Tanjim67/interactive-system/resource/Pressure sensor method 1/IMG_20200611_221741.jpg

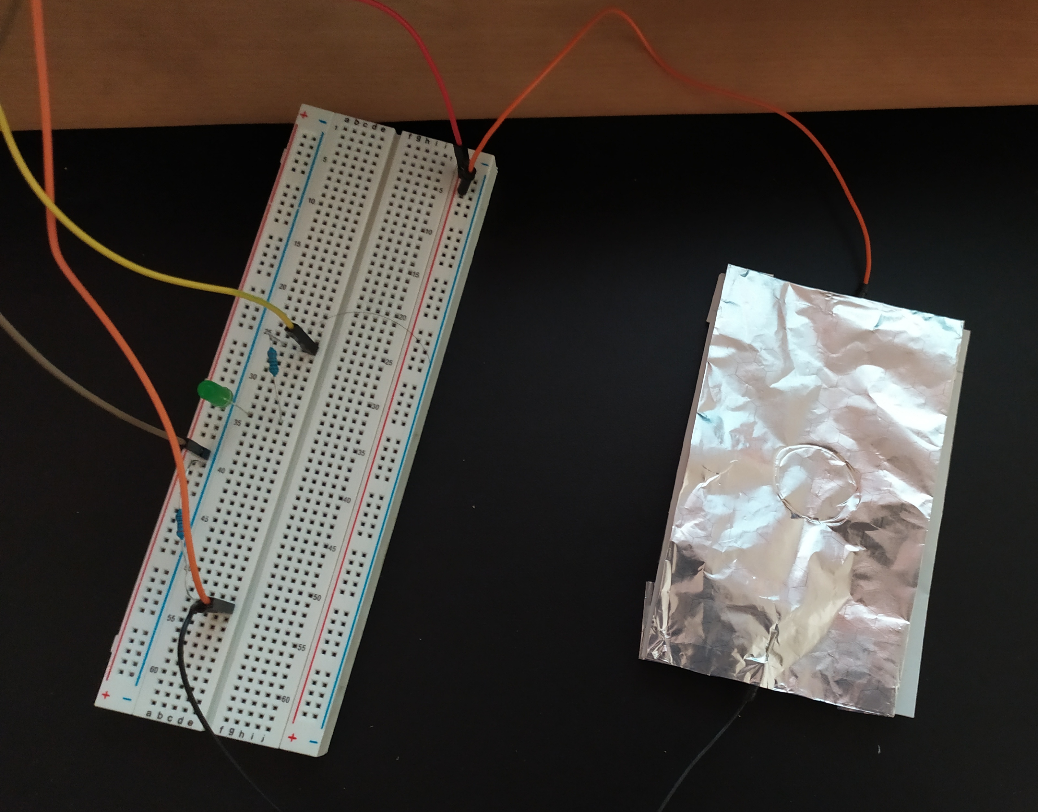
resource/Pressure sensor method 1/IMG_20200611_221741.jpg
