Tanjim67/interactive-system/resource/Pressure Sensor Method 2/IMG_20200622_030150.jpg

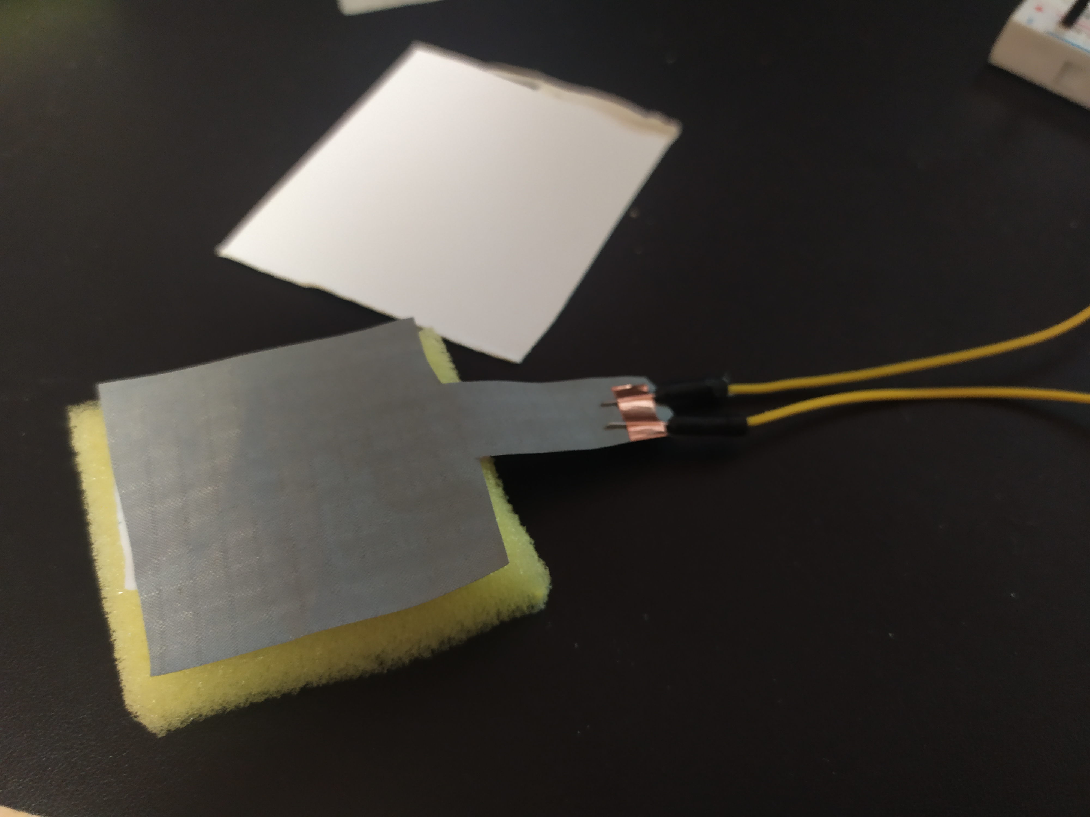
resource/Pressure Sensor Method 2/IMG_20200622_030150.jpg
