Tanjim67/interactive-system/data/1velostat.PNG

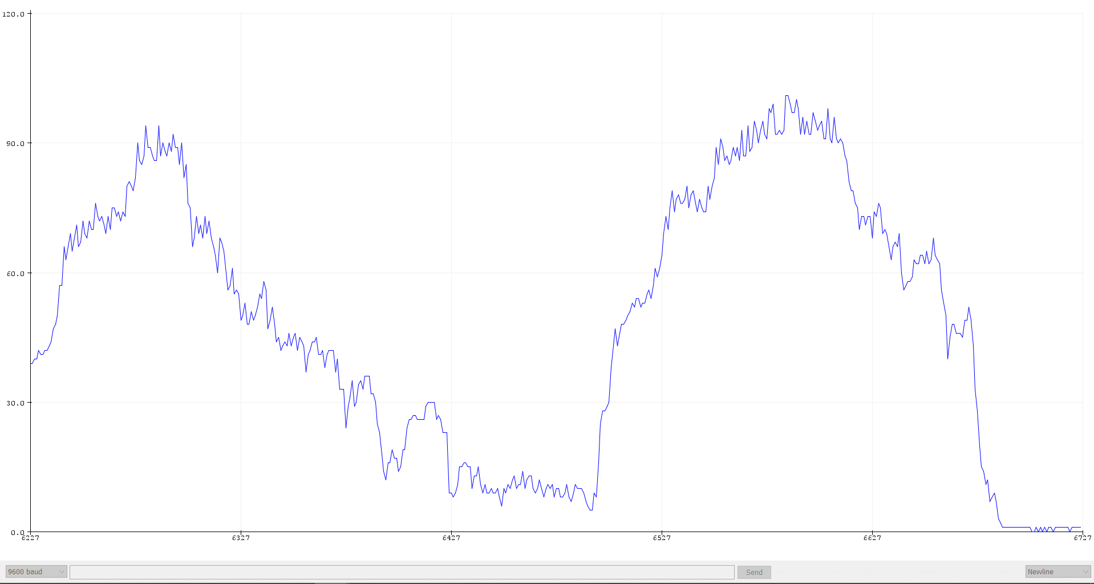
data/1velostat.PNG
