Tanjim67/interactive-system/data/3velostat.PNG

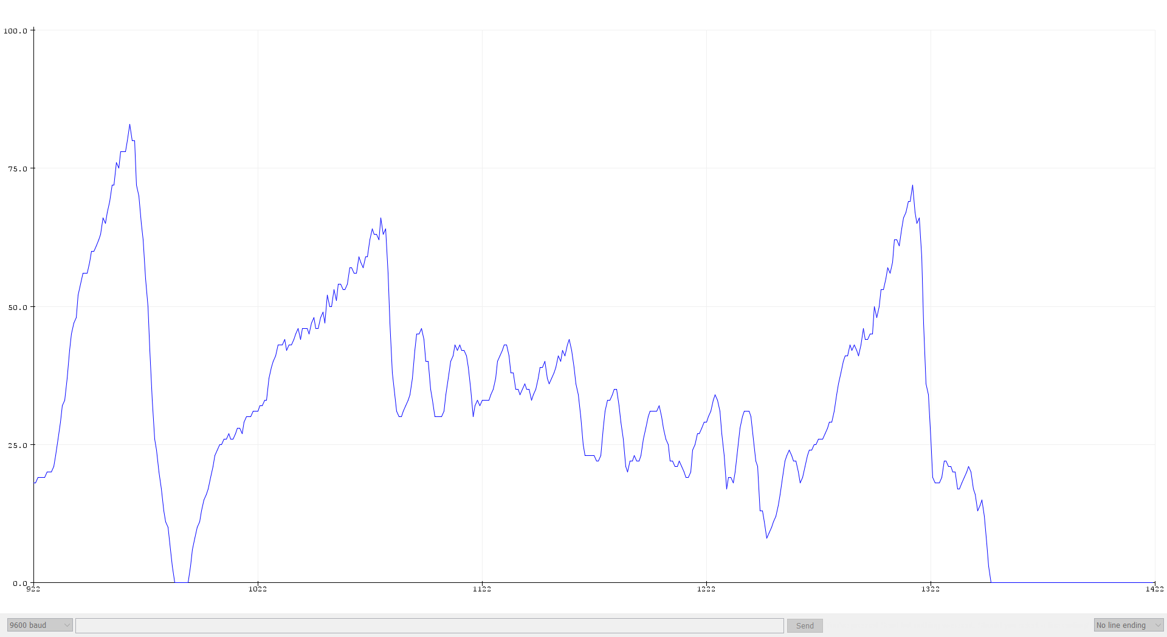
data/3velostat.PNG
