Tanjim67/interactive-system/data/Pressure Sensor M1 data read 2.png

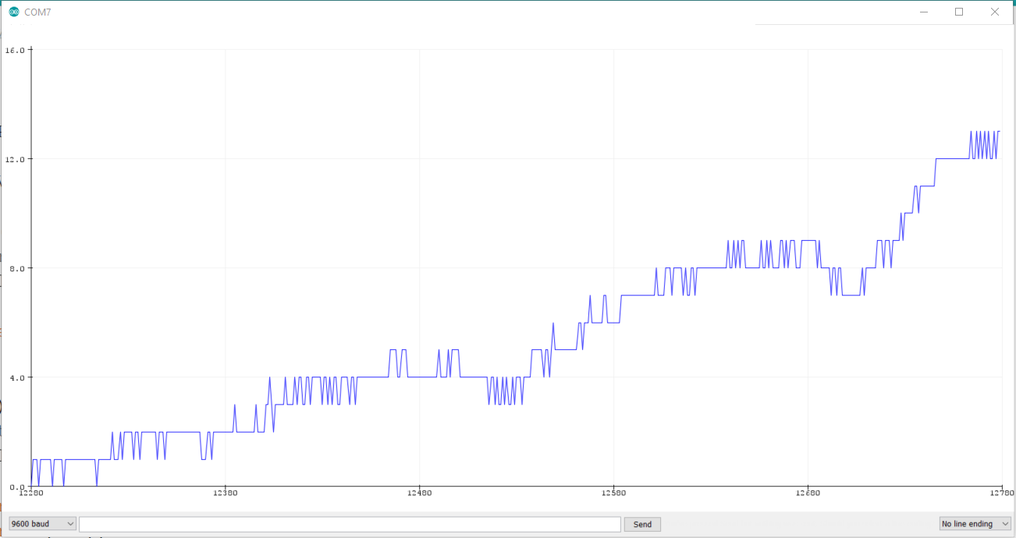
data/Pressure Sensor M1 data read 2.png
