Tanjim67/interactive-system/data/Pressure Sensor M1 data read 3.png

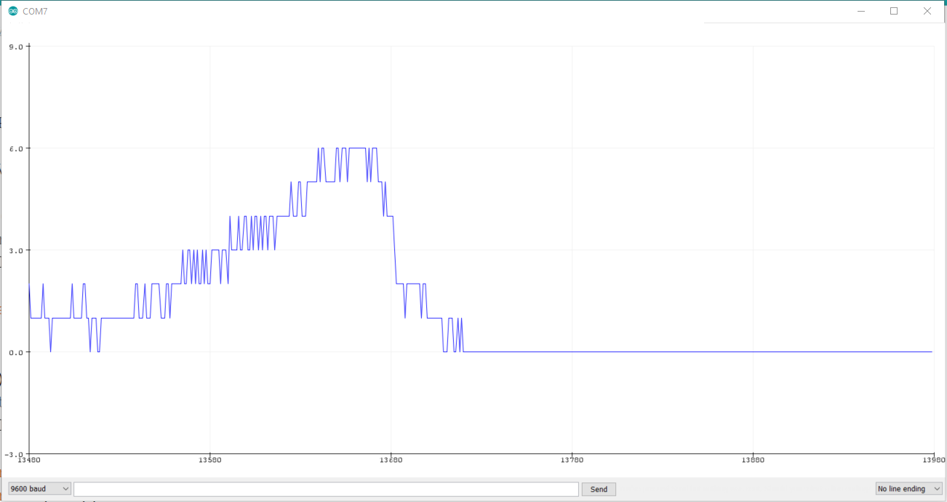
data/Pressure Sensor M1 data read 3.png
