Tanjim67/interactive-system/data/velostat5.PNG

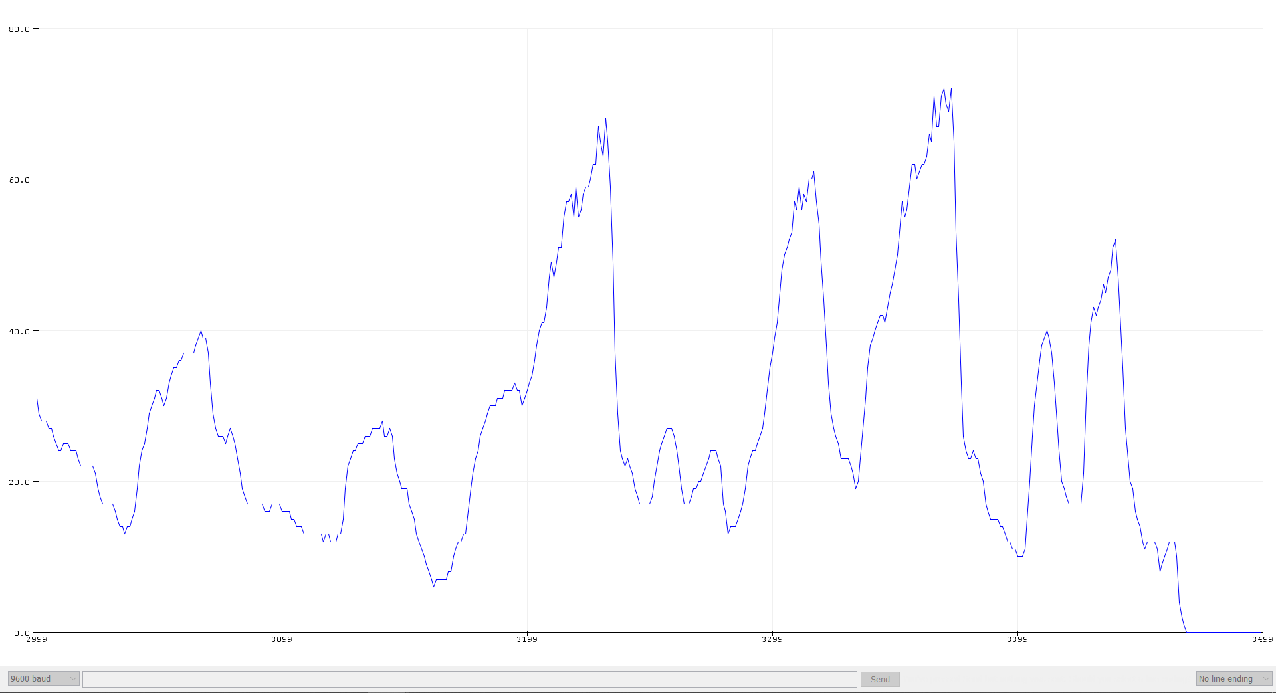
data/velostat5.PNG
