Tanjim67/interactive-system/data/velostat+sponge.PNG

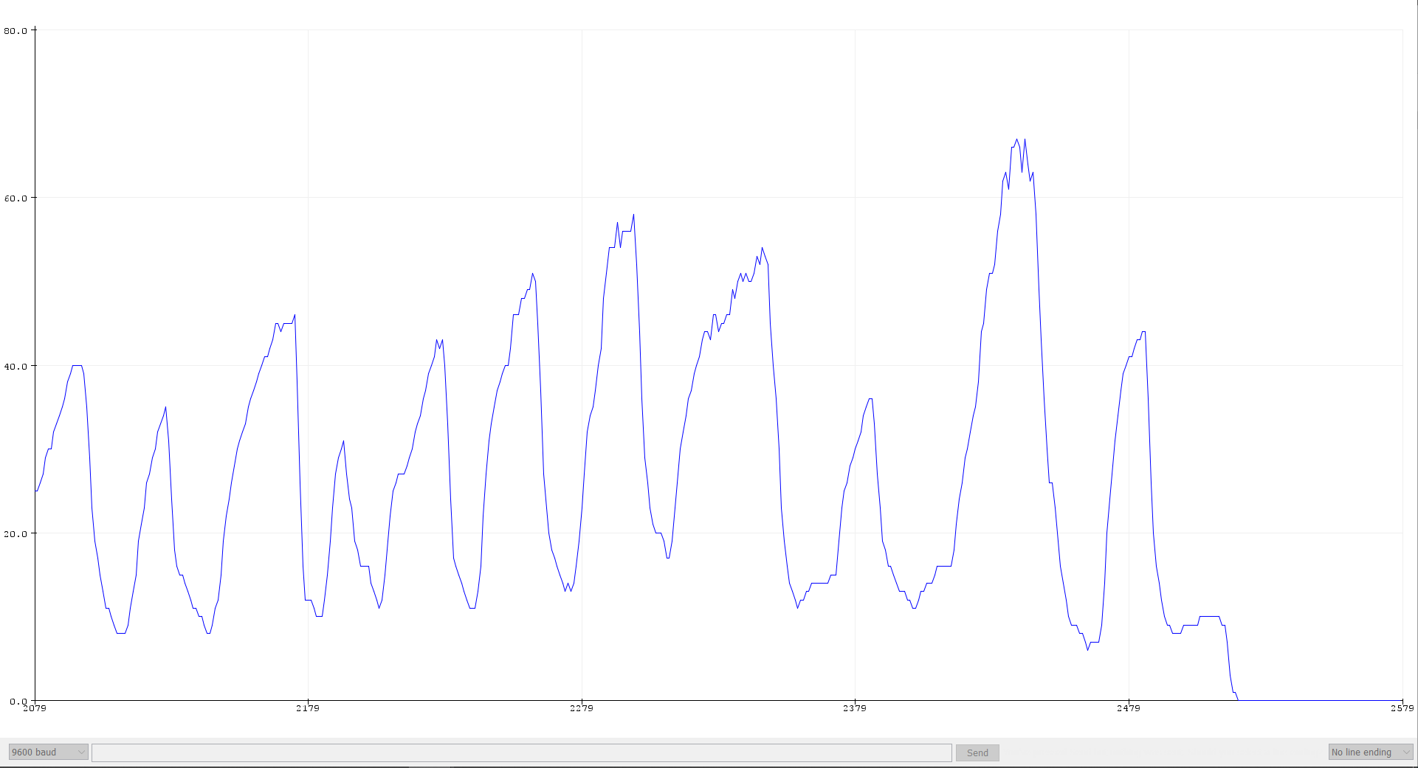
data/velostat+sponge.PNG
