Tanjim67/interactive-system/resource/Design/basicidea.png

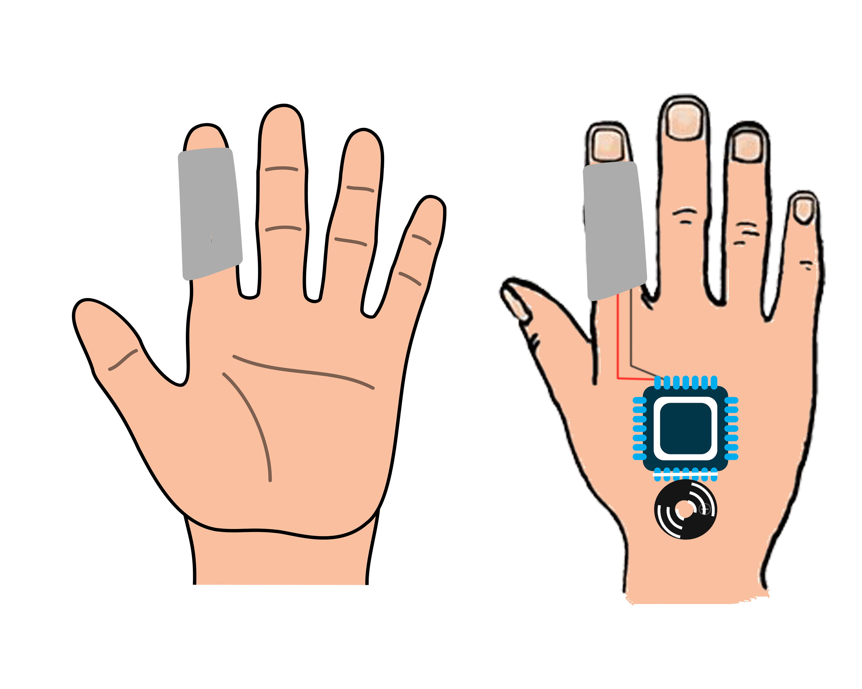
resource/Design/basicidea.png
