Tanjim67/interactive-system/resource/Design/sensor 2.png

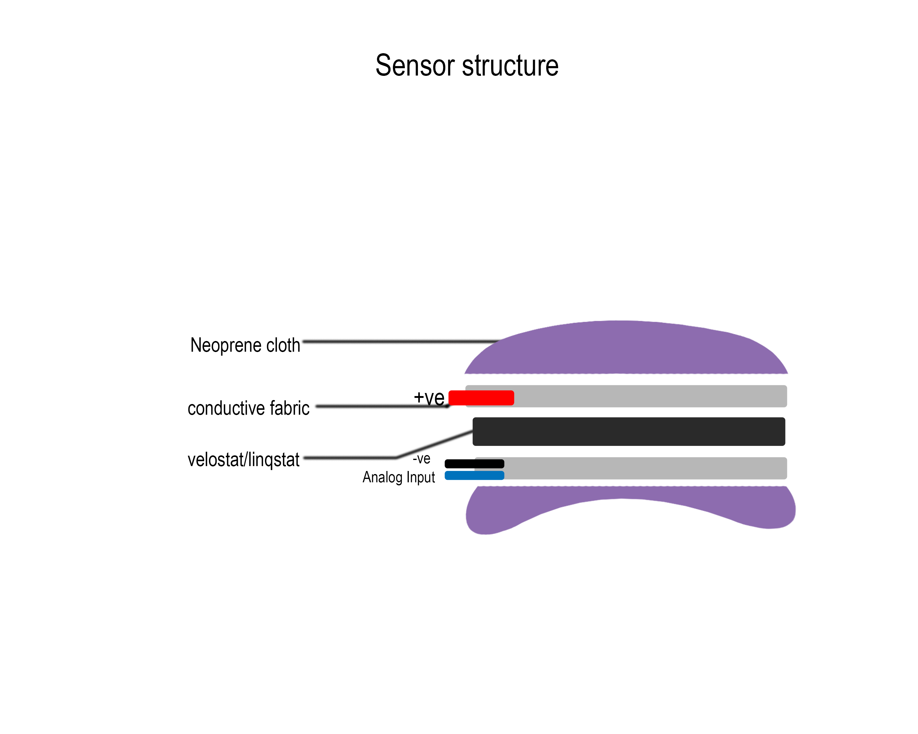
resource/Design/sensor 2.png
