Tanjim67/interactive-system/resource/Design/struc.png

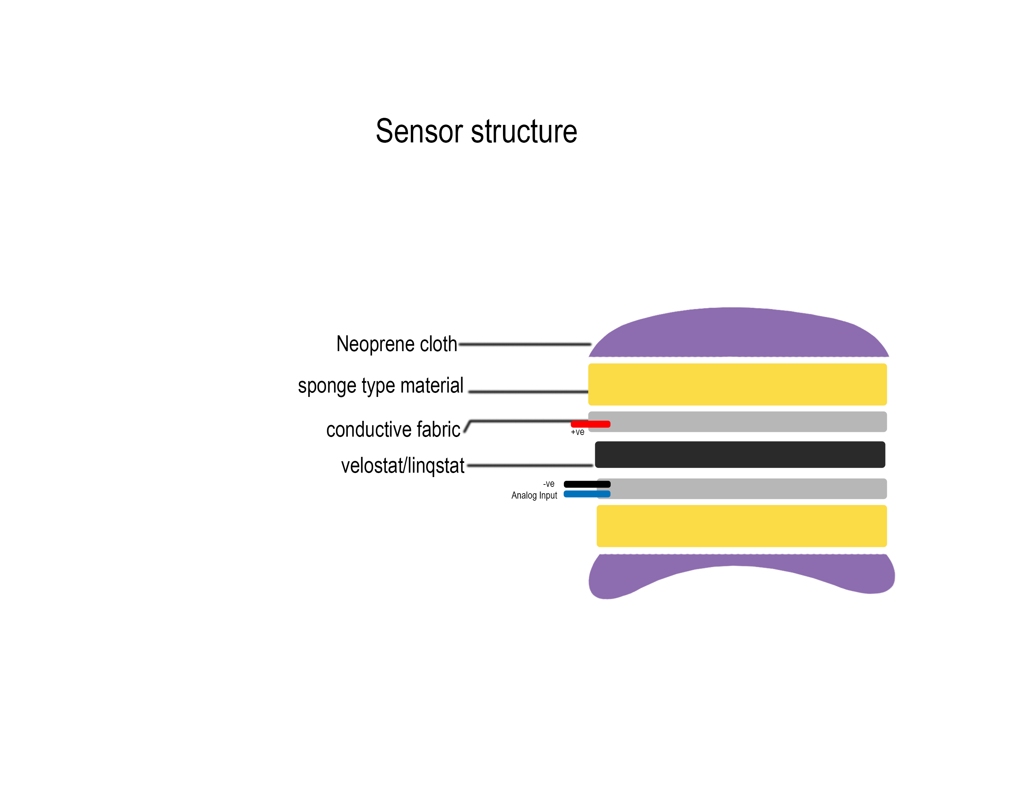
resource/Design/struc.png
