Tanjim67/interactive-system/resource/Design/Untitled-1.png

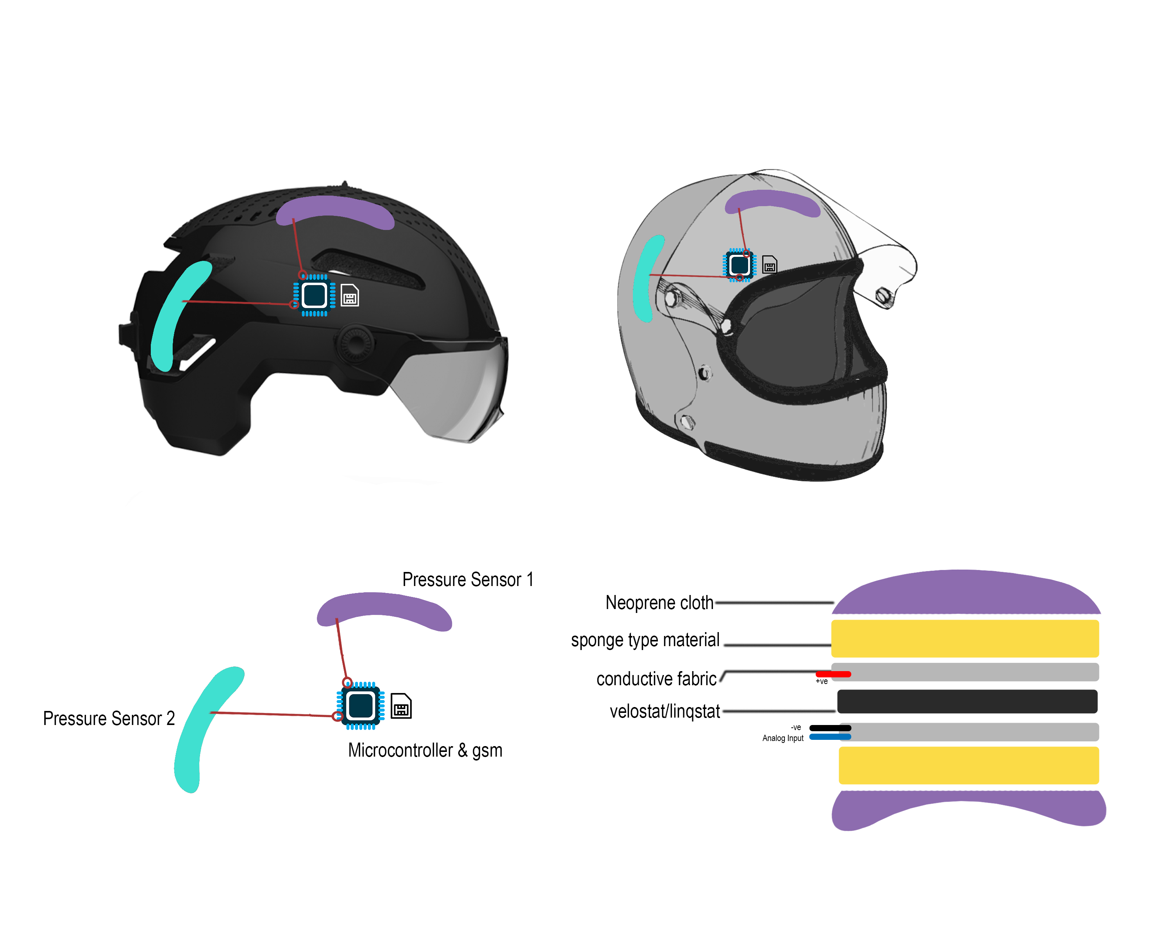
resource/Design/Untitled-1.png
