Tanjim67/interactive-system/resource/Final Prototype schematic.png

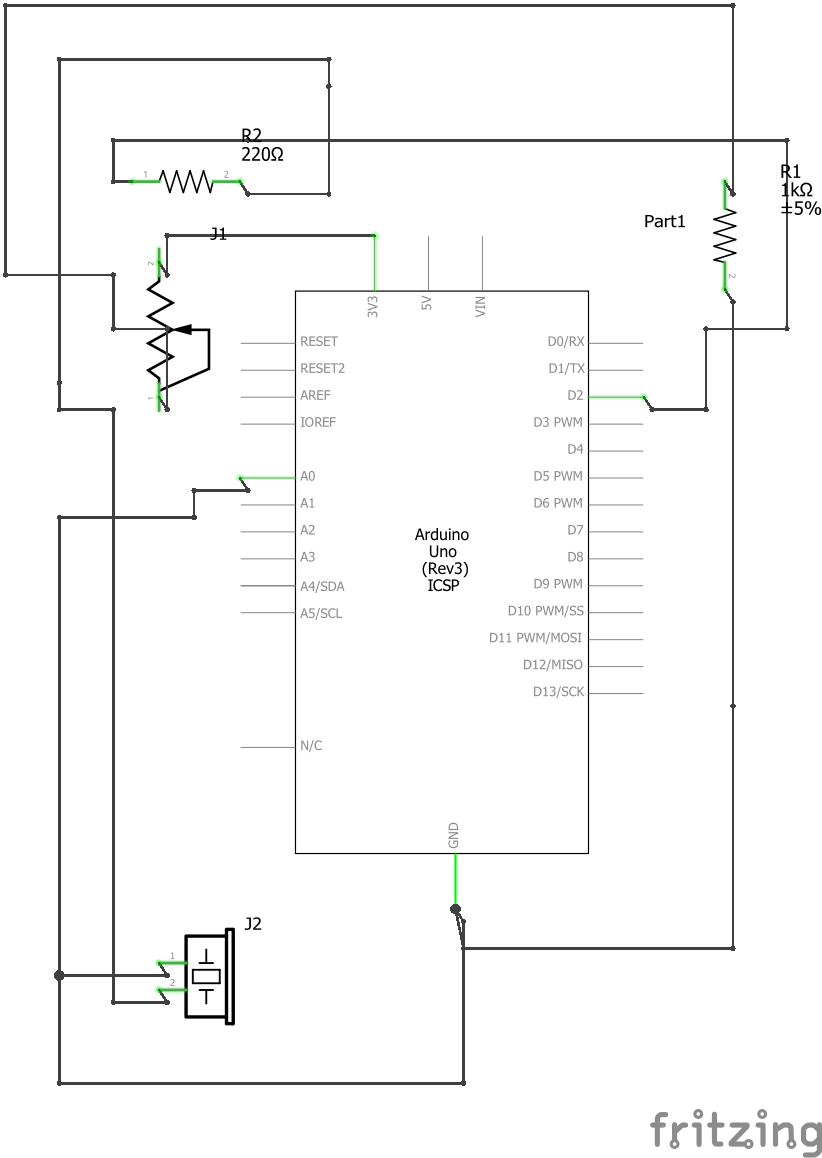
resource/Final Prototype schematic.png
