Tanjim67/interactive-system/resource/Pressure sensor method 1/IMG_20200611_182945.jpg

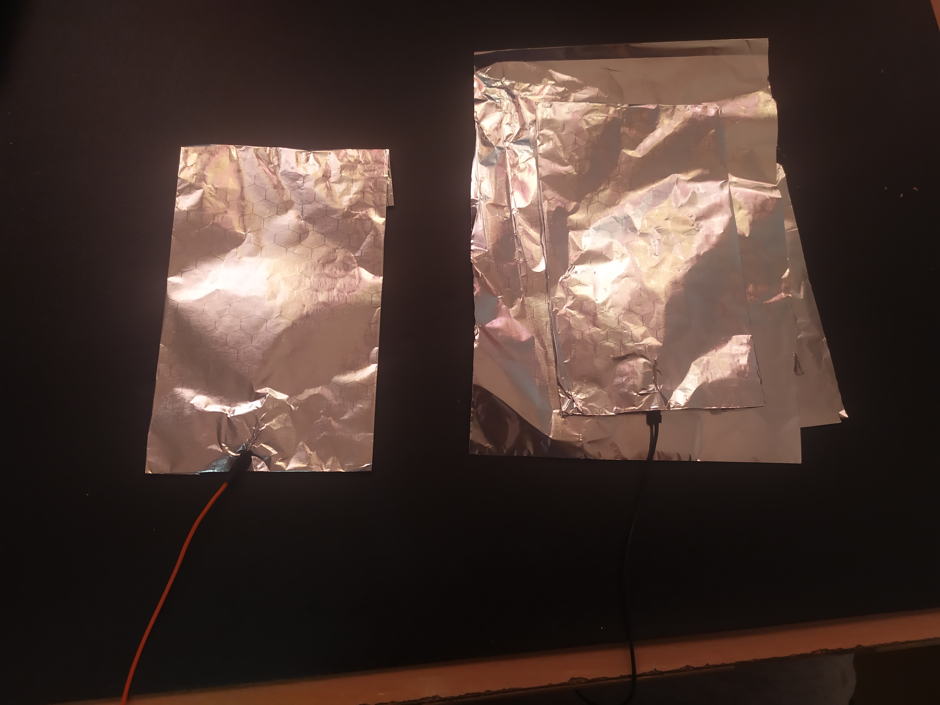
resource/Pressure sensor method 1/IMG_20200611_182945.jpg
