Tanjim67/interactive-system/resource/Pressure sensor method 1/IMG_20200611_221701.jpg

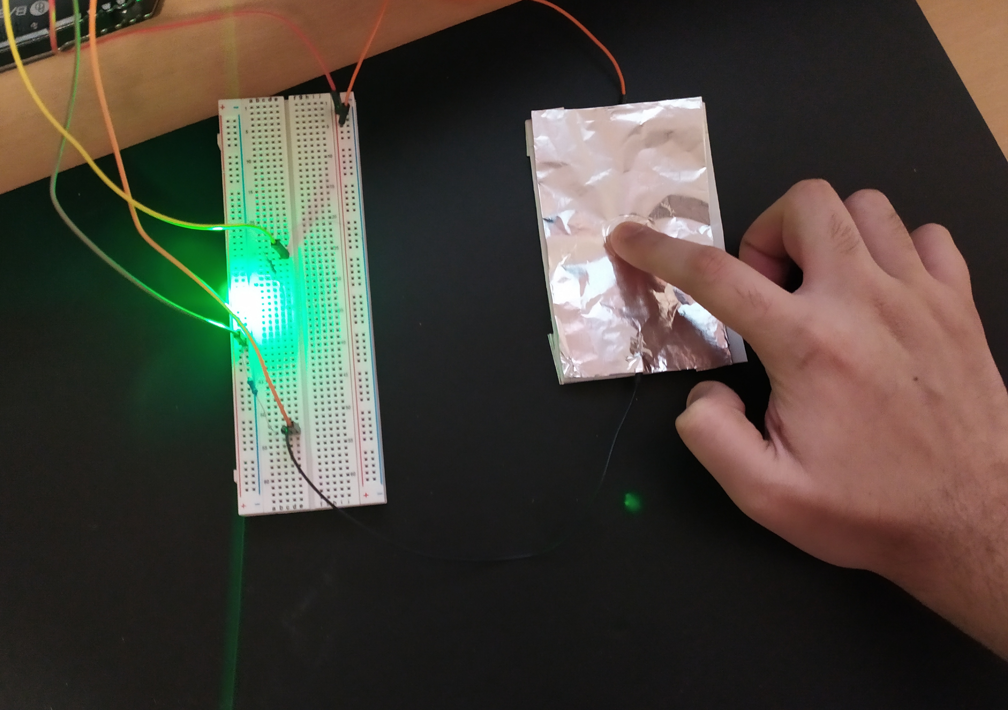
resource/Pressure sensor method 1/IMG_20200611_221701.jpg
