Tanjim67/interactive-system/resource/Pressure sensor method 1/IMG_20200611_221814.jpg

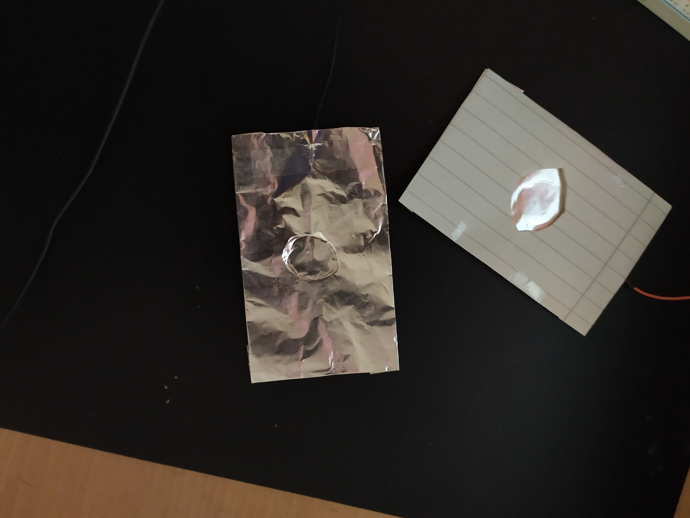
resource/Pressure sensor method 1/IMG_20200611_221814.jpg
