Tanjim67/interactive-system/resource/Pressure Sensor Method 3/sensor structure.jpg

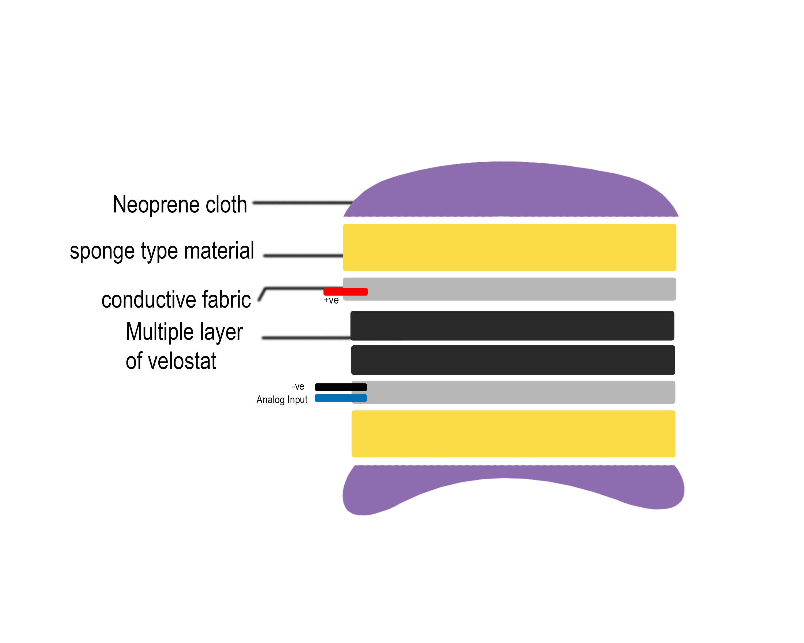
resource/Pressure Sensor Method 3/sensor structure.jpg
