Tanjim67/interactive-system/doc/Task distribution for IAS'20 project _Pressure Power!_.pdf

# Task distribution for IAS'20 project "Pressure Power!"

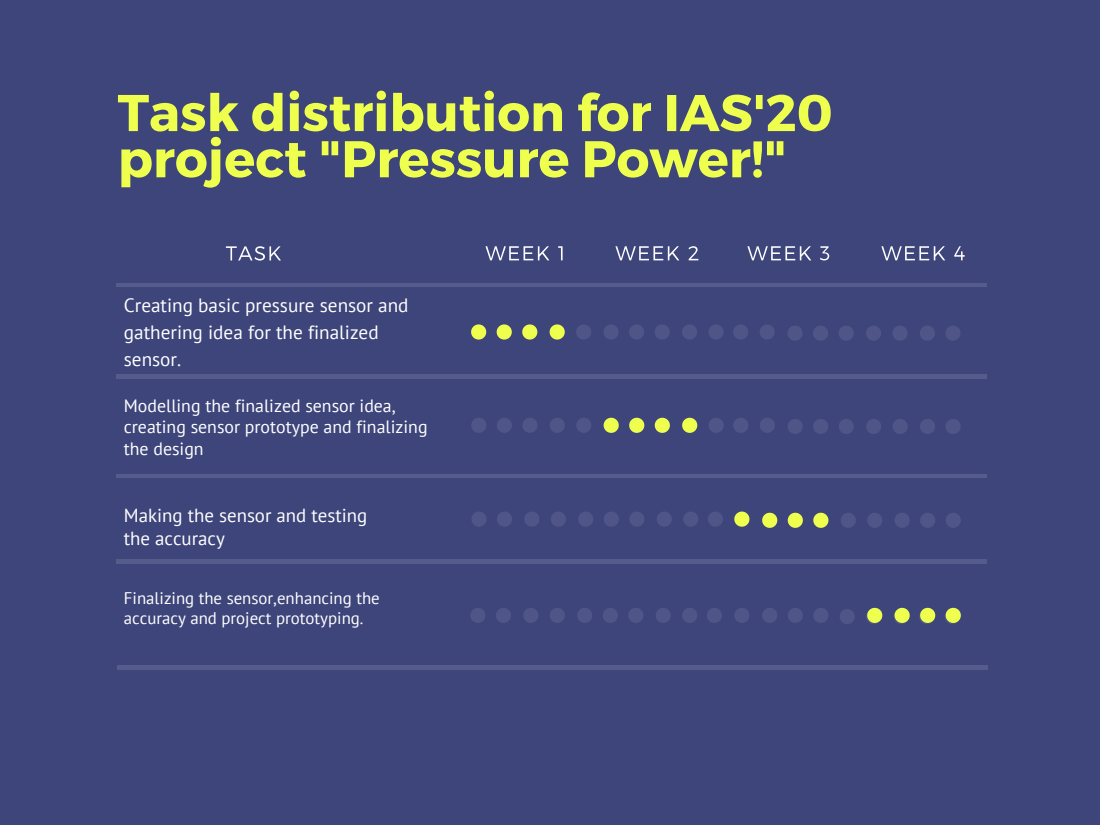
[picture p38: page 1]
TASK; WEEK 1; WEEK 2; WEEK 3; WEEK 4

Creating basic pressure sensor and
gathering idea for the finalized
sensor.

Modelling the finalized sensor idea,
creating sensor prototype and finalizing
the design

Making the sensor and testing
the accuracy

Finalizing the sensor,enhancing the
accuracy and project prototyping.

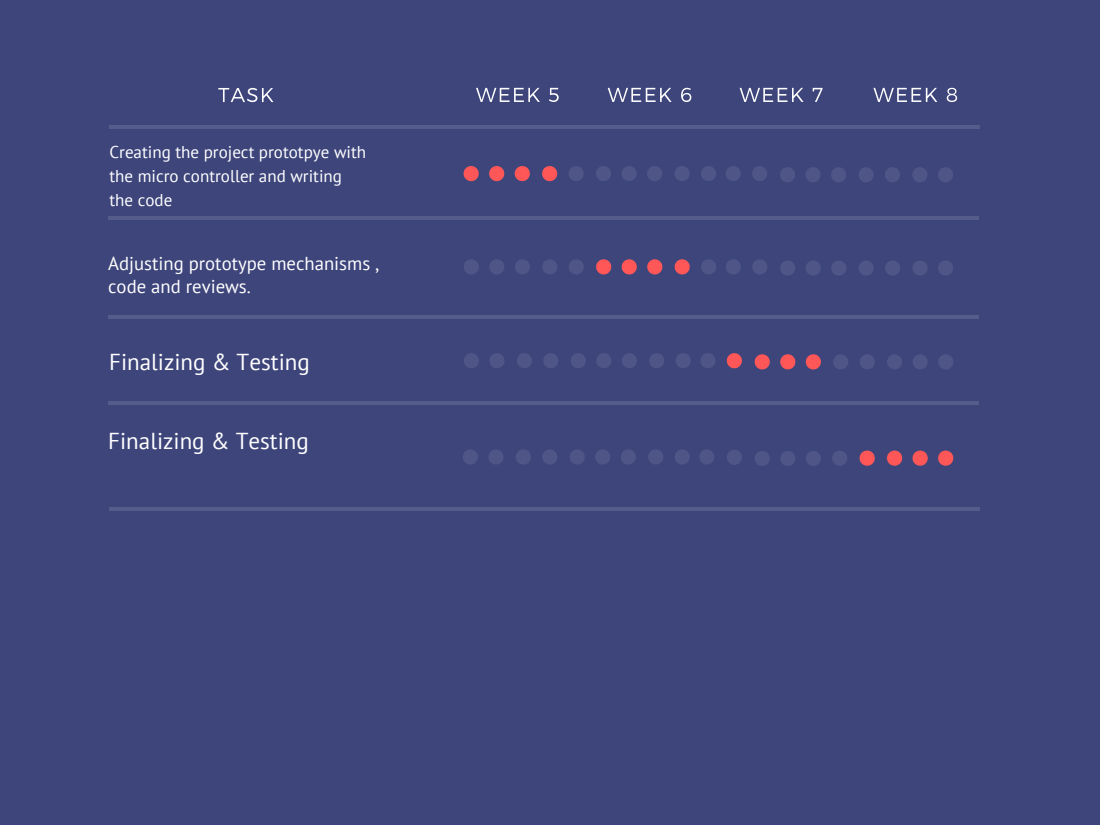
[picture p39: page 2]
Finalizing & Testing; TASK; WEEK 5; WEEK 6; WEEK 7; WEEK 8

Creating the project prototpye with
the micro controller and writing
the code

Adjusting prototype mechanisms ,
code and reviews.
